andrew-bushuev/imx233/README.md

# imx233

Here is all the materials about the singleboard PC based on NXP/Freesacle iMX233 SoC.
