andrew-bushuev/imx233/IMX233 Assembly/IMX233_REV1 Schematic.pdf

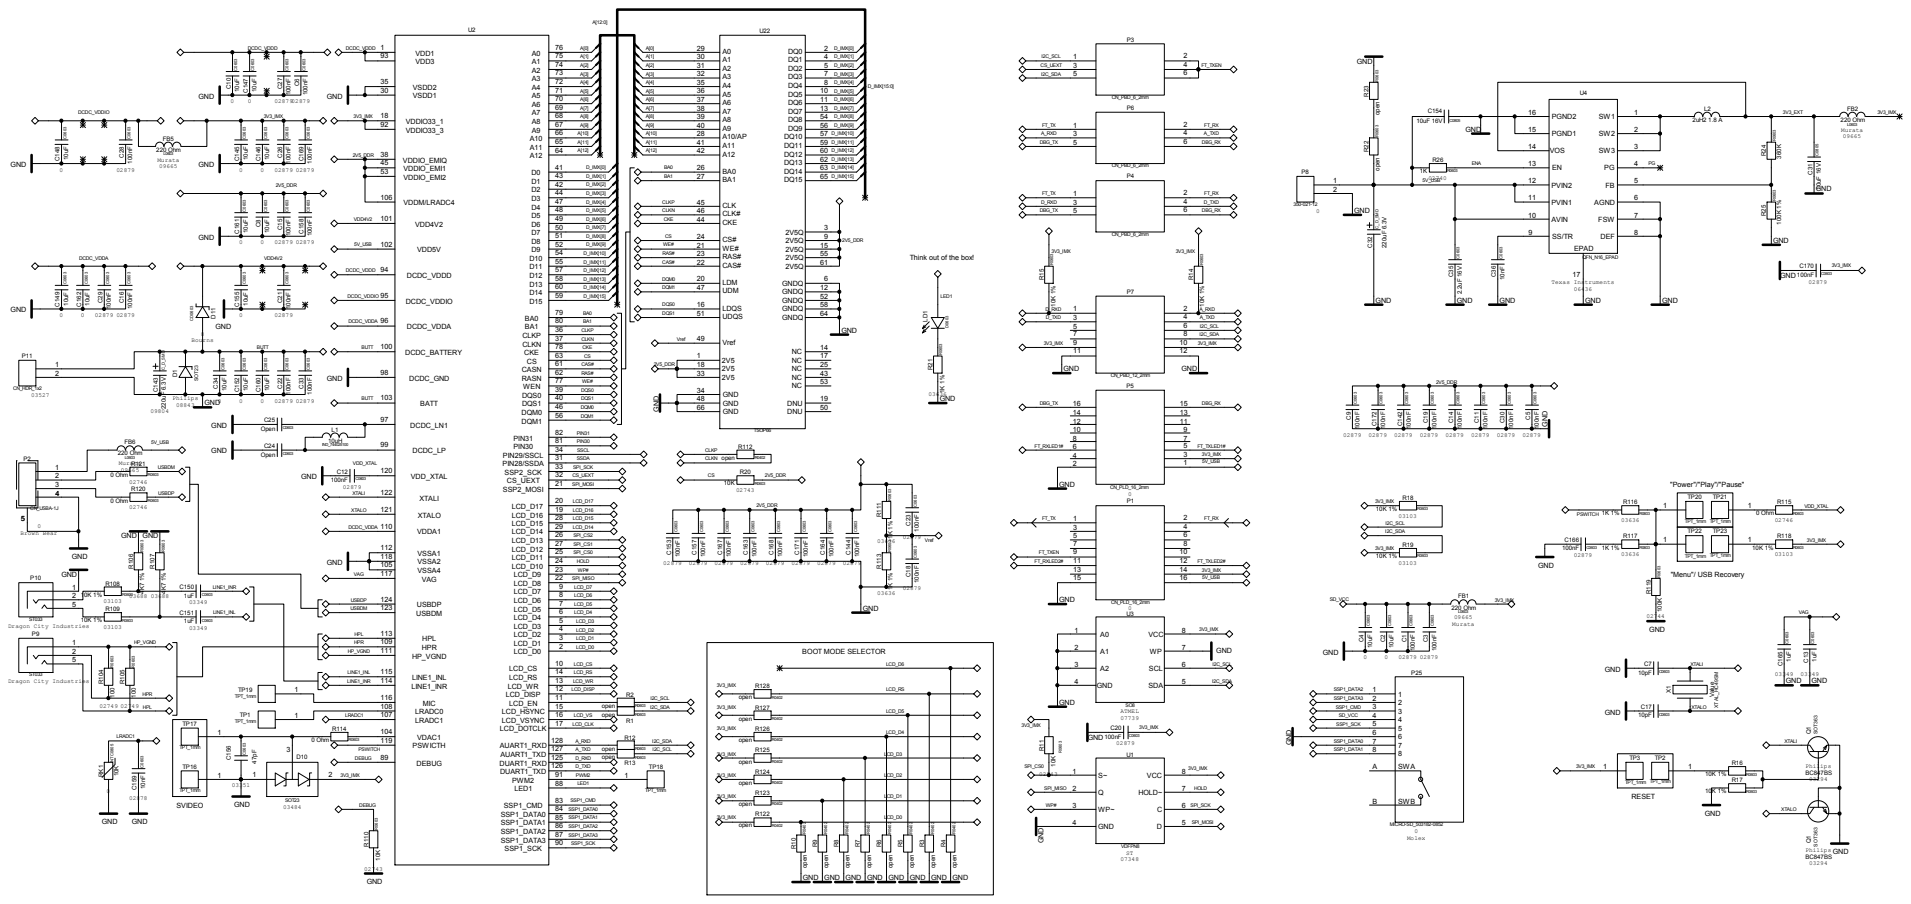
[picture p5: page 1]

GND GND
