andrew-bushuev/imx233/IMX233 Assembly/IMX233_REV1_Fabrication.pdf

E

E

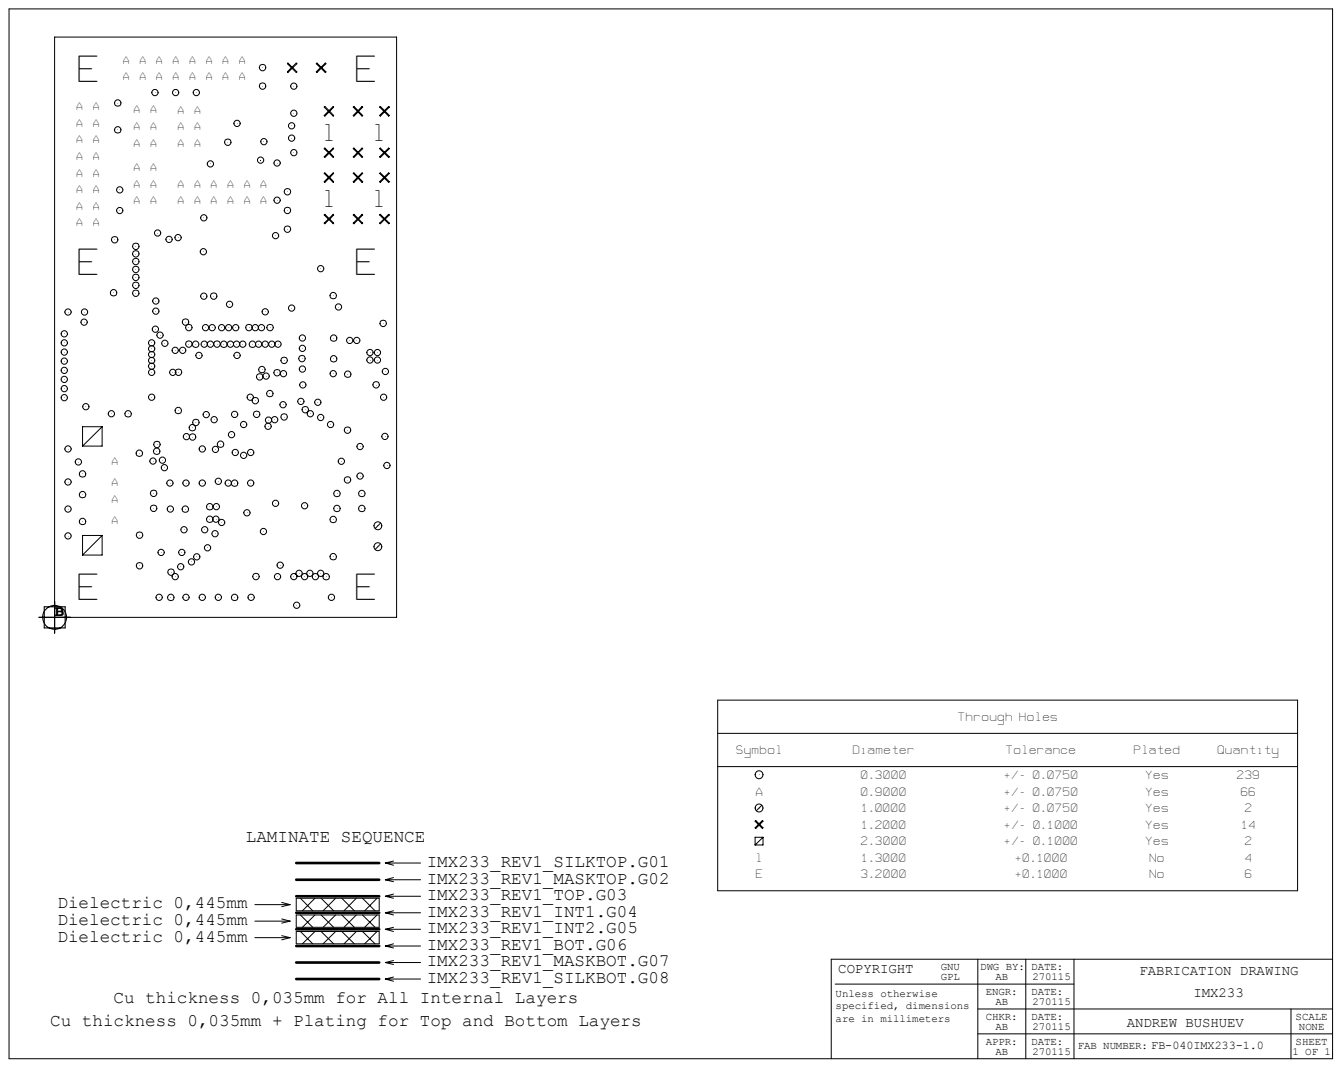
[picture p6: page 1]
LAMINATE SEQUENCE; IMX233_REV1_SILKTOP.G01 IMX233_REV1_MASKTOP.G02 IMX233_REV1_TOP.G03 IMX233_REV1_INT1.G04 IMX233_REV1_INT2.G05 IMX233_REV1_BOT.G06 IMX233_REV1_MASKBOT.G07 IMX233_REV1_SILKBOT.G08; Dielectric 0,445mm Dielectric 0,445mm Dielectric 0,445mm; FAB NUMBER:; FABRICATION DRAWING; FB-040IMX233-1.0; SHEET; NONE; IMX233; APPR:; CHKR:; ENGR:; COPYRIGHT; DWG BY:; DATE:; 270115 GNU; GPL; Through Holes; Plated; Quantity; Yes Yes Yes Yes Yes; Tolerance; Symbol; Diameter

Cu thickness 0,035mm for All Internal Layers

Unless otherwise
specified, dimensions
are in millimeters

Cu thickness 0,035mm + Plating for Top and Bottom Layers

SCALE ANDREW BUSHUEV
