andrew-bushuev/imx233/LC4.pdf

76
75

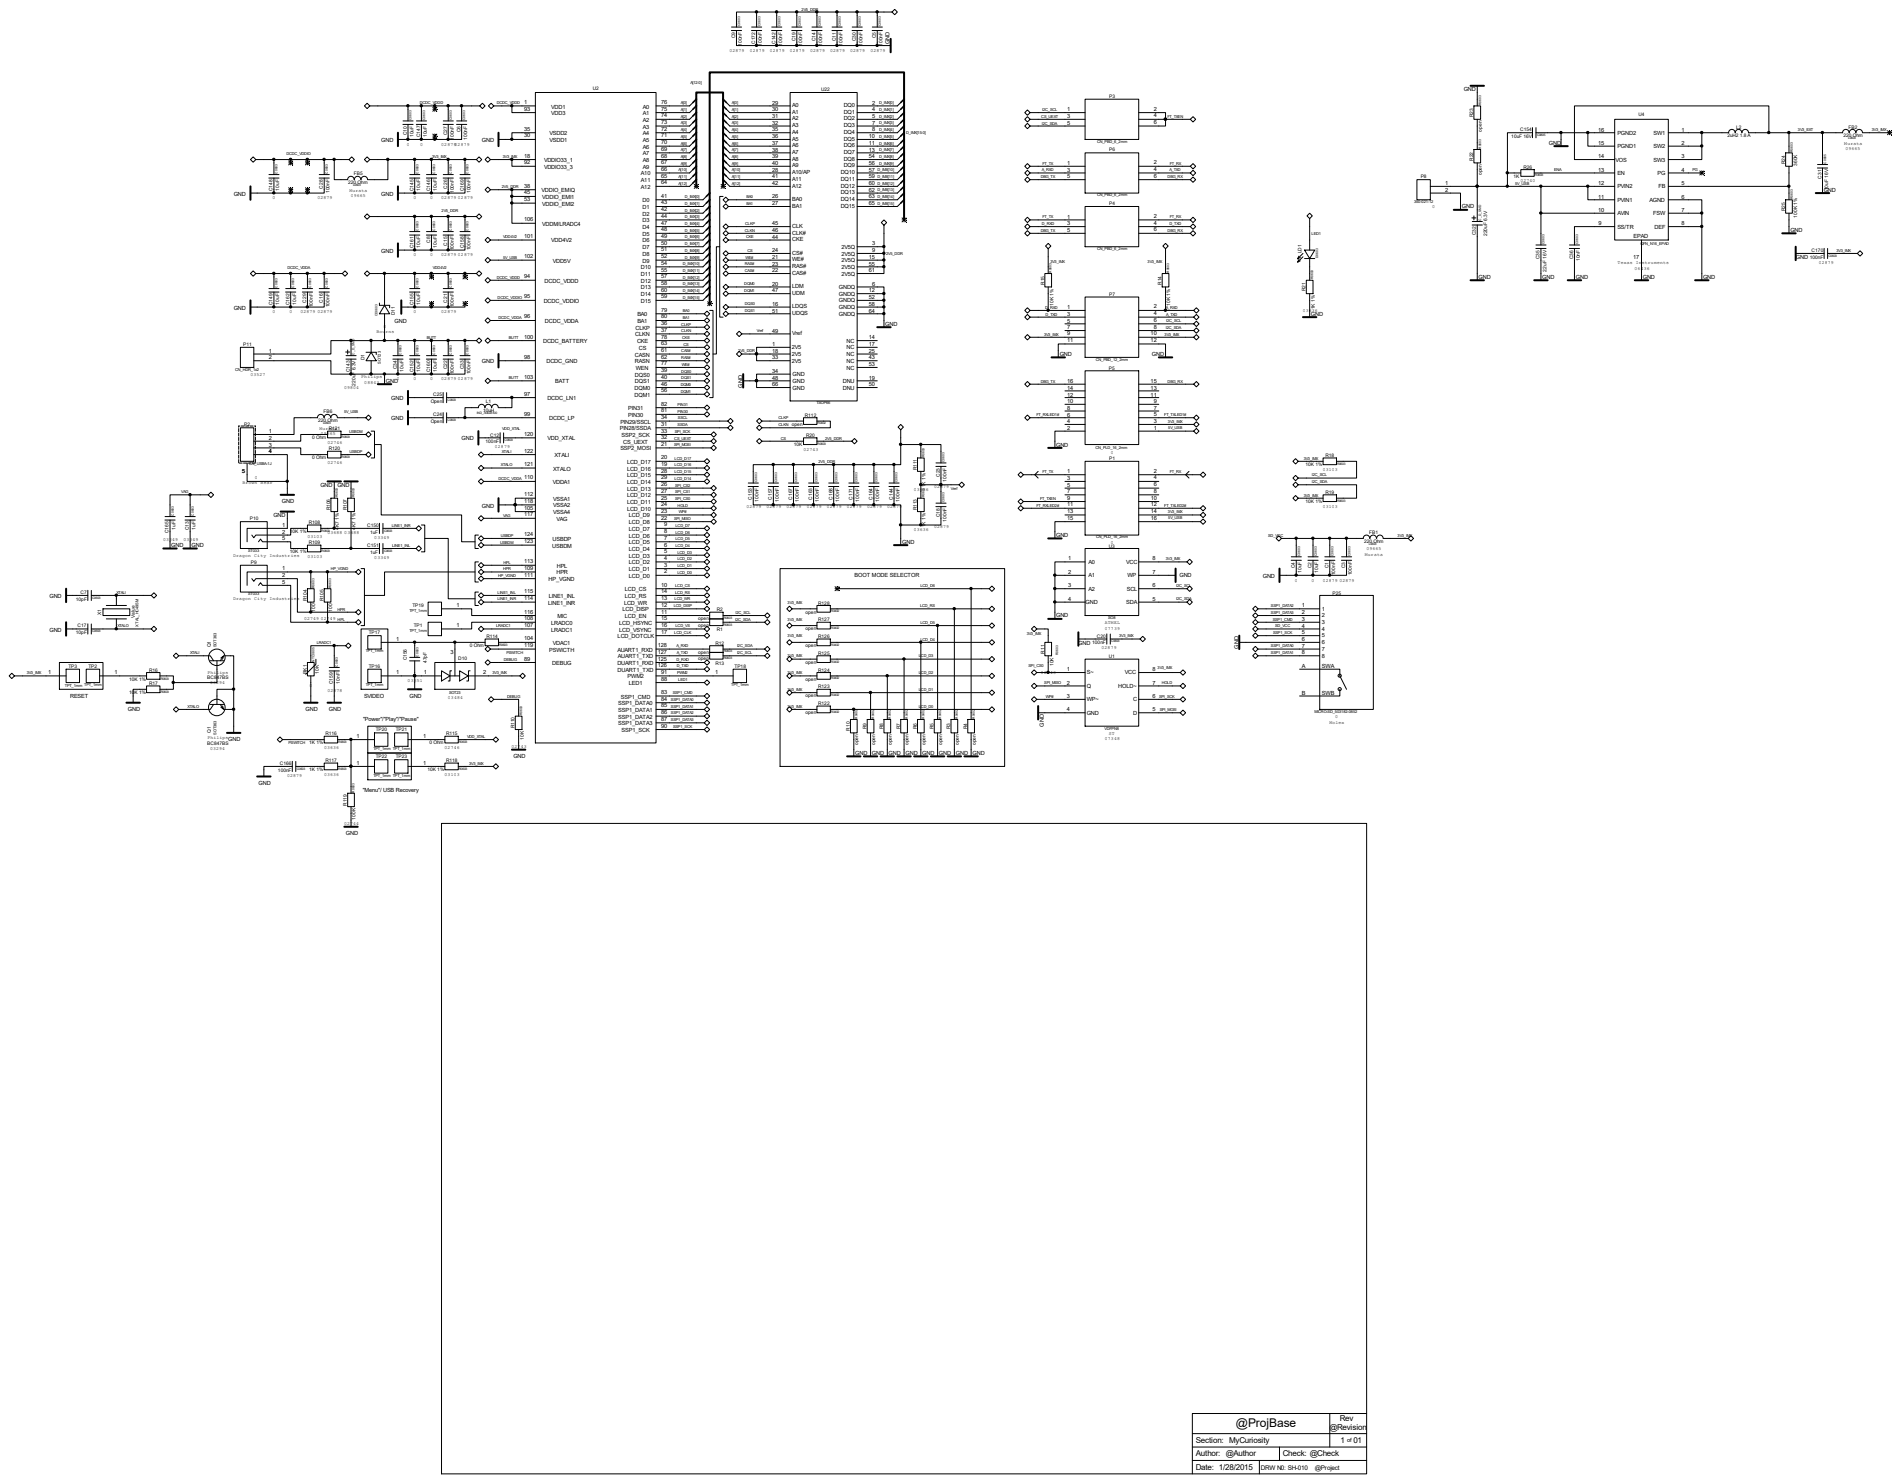
[picture p7: page 1]

0 C⁰⁶⁰³ | C²⁶ C⁰⁶⁰³ | A[9] 40 56 D_IMX[9] A[10] 28 57 D_IMX[10]

10K 1% R¹⁴ R⁰⁶⁰³ 10K ¹% R¹⁵ R⁰⁶⁰³ 10K ¹%

LCD_D1
GND R⁶ open R⁰⁴⁰²

GND R⁵ R⁰⁴⁰² open

GND R³ R⁰⁴⁰² open

GND R⁴ open R⁰⁴⁰²

GND GND
