andrew-bushuev/imx233/IMX233 Assembly/Assembling TOP IMX233 PCB1.0 BOM1.0 2015-01-27 (Single).pdf

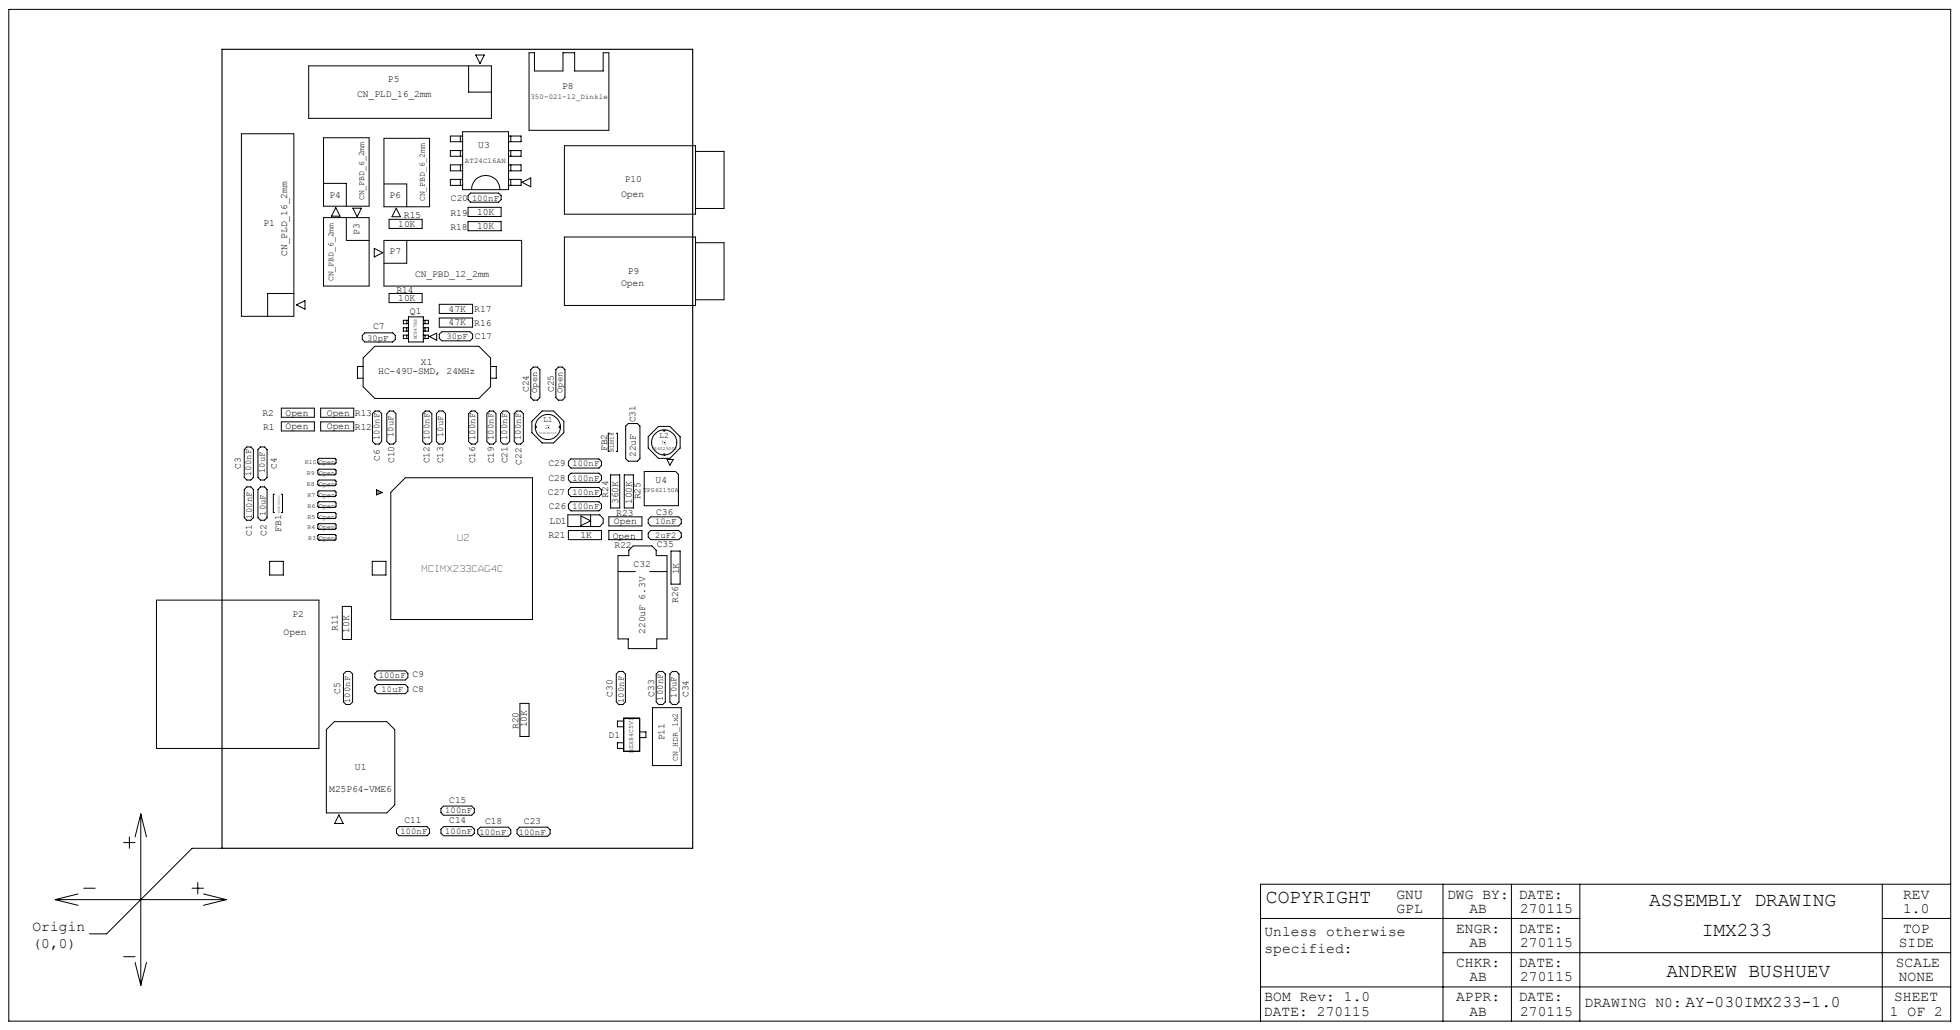
[picture p9: page 1]
