andrew-bushuev/imx233/(list of files, drawings)

Other design files:
LC4_REV3.PcbDoc
