andrew-bushuev/imx233/(commit log)

2017-08-28 upd: uploading Altium PcbDoc
    upd: uploaded Altium PcbDoc may contain errors, please review it carefully
    [LC4_REV3.PcbDoc]
2021-09-13 LC4.pdf
    The schematic of the SBC
